DylanMills/ControllerDesign/images/20241011_081829.jpg

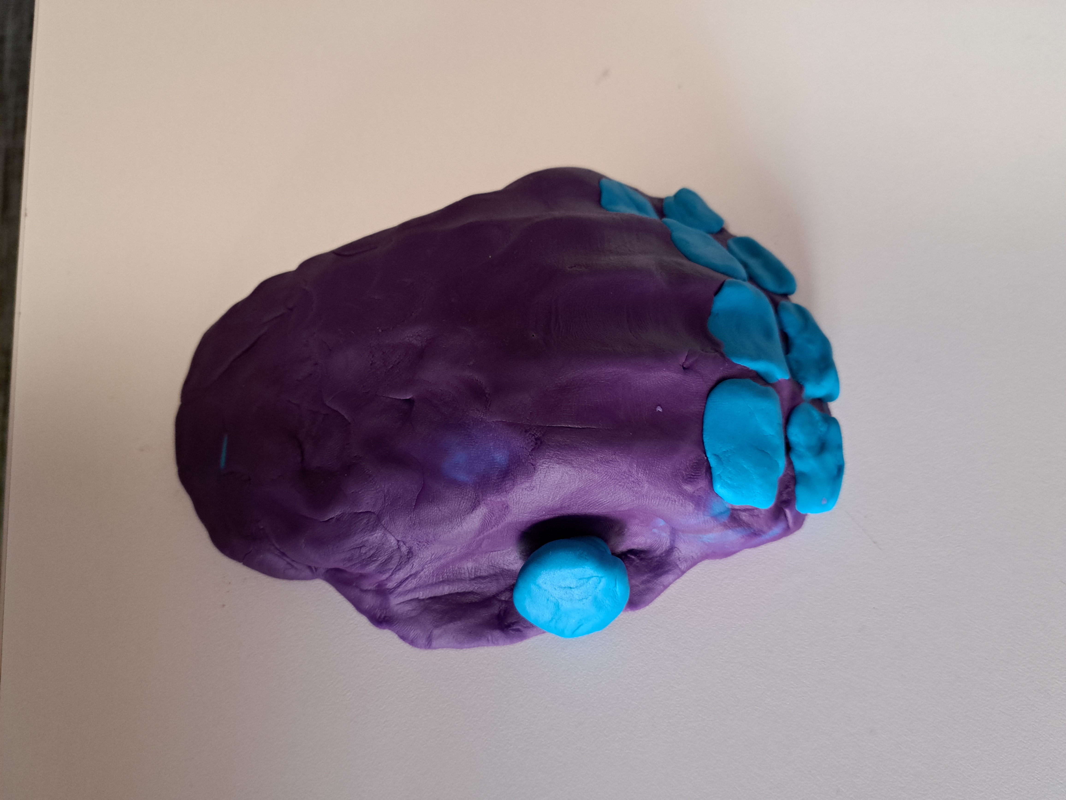
images/20241011_081829.jpg
