DylanMills/ControllerDesign/images/newcontroller.png

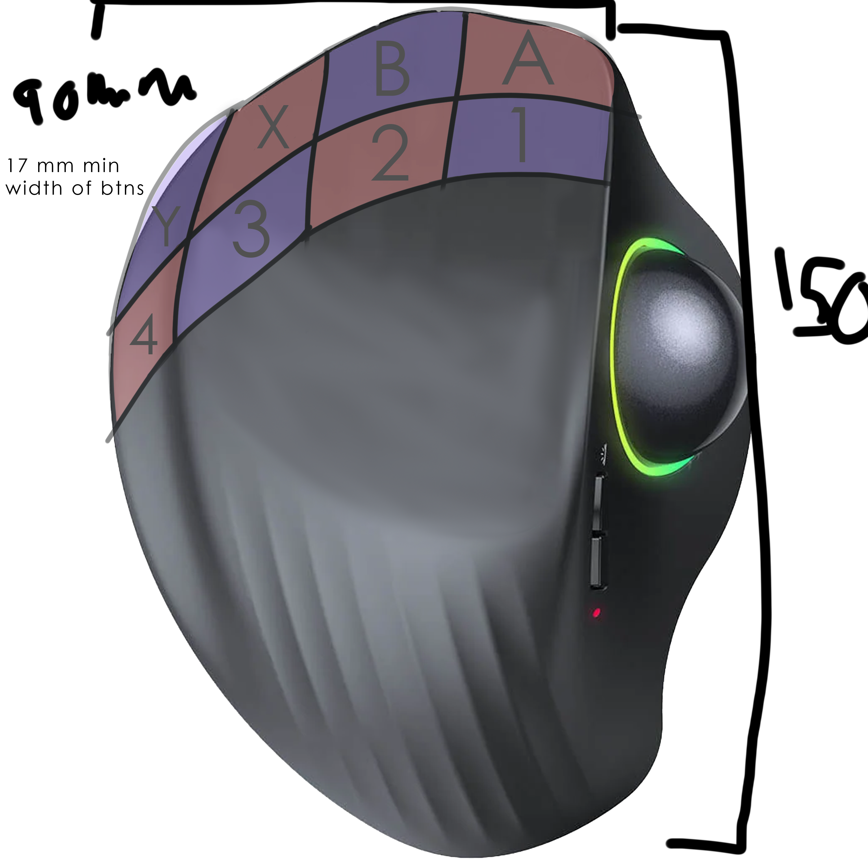
images/newcontroller.png
