DylanMills/ControllerDesign/README.md

# ControllerDesign

### - Dylan Mills
### - Willow Forte

# Overview

This is the design for the new gaming controller, made for PC gamers who want the fluidity of joystick movement and a more ergonomic button layout.

# Links

## Assignment 1
### [Assignent 1 Report PDF](https://github.com/DylanMills/ControllerDesign/blob/main/New%20Input%20Device%20Report.pdf)
### [Wokwi export, with diagram and final Arduino sketch code](https://github.com/DylanMills/ControllerDesign/tree/main/wokwi-diagram-final)
### [Final Demo Video](https://drive.google.com/file/d/1OGJHtCMRwxnxY_OZRE3Fgz9Ho02UFsNs/view?usp=sharing)

## Assignment 2

### [Fusion Project](https://a360.co/3YInzAM)
### [Youtube Presentation](https://youtu.be/R_m9BKb6MnA)
### [Drawings PDF](https://github.com/DylanMills/ControllerDesign/blob/main/ControllerDWG.pdf)
