DylanMills/ControllerDesign/images/20241011_081821.jpg

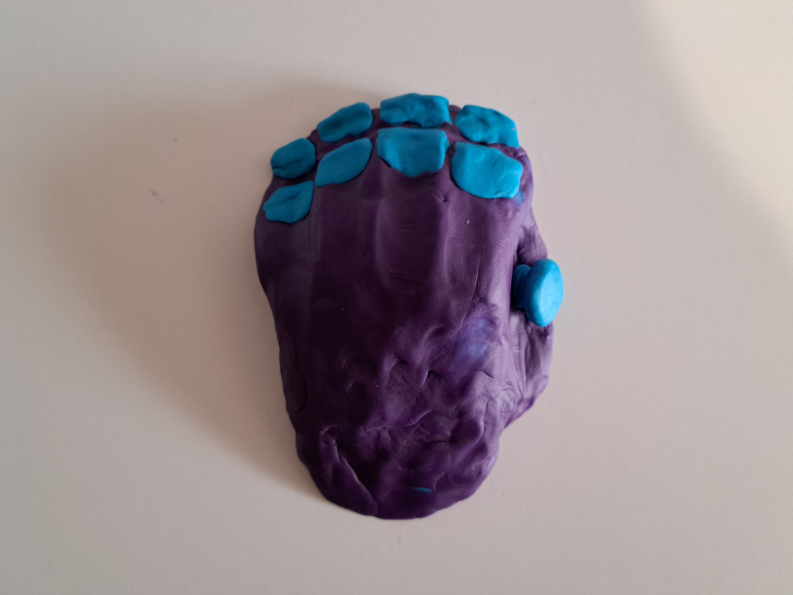
images/20241011_081821.jpg
