DylanMills/ControllerDesign/images/20241011_081920.jpg

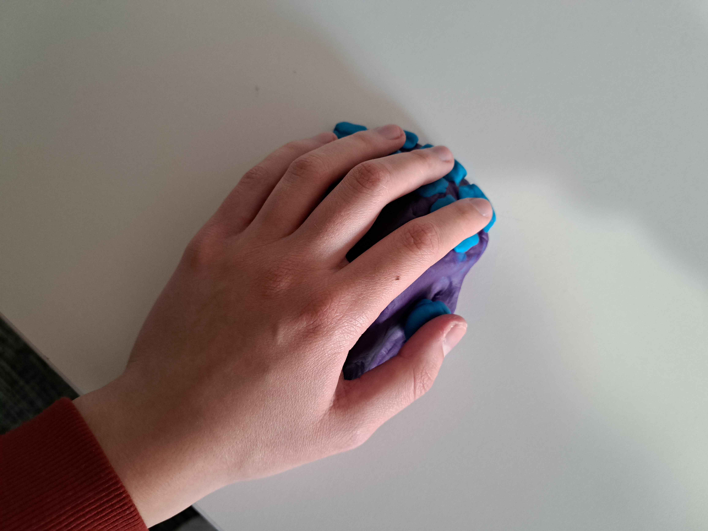
images/20241011_081920.jpg
