DylanMills/ControllerDesign/images/proto_sketches.png

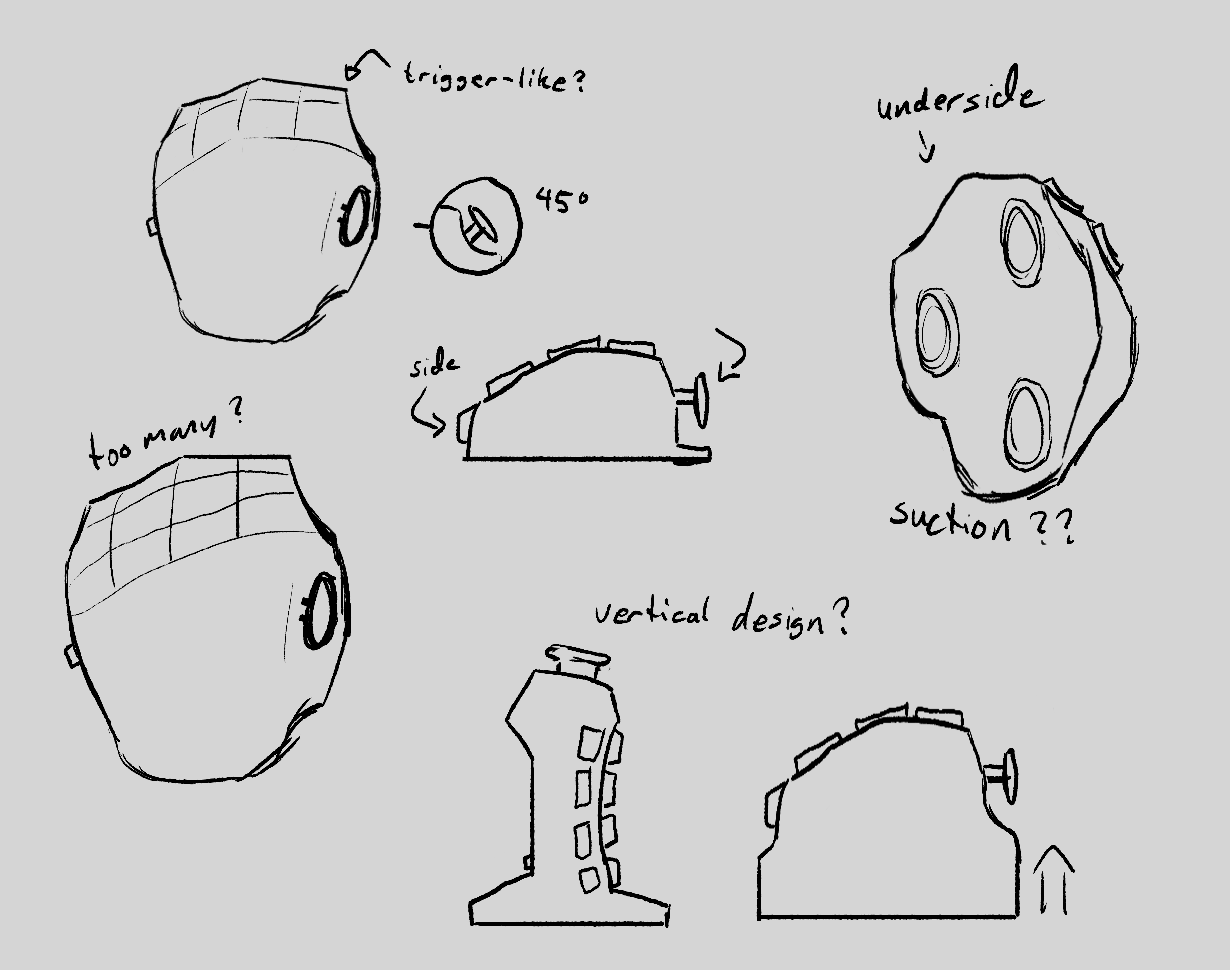
images/proto_sketches.png
