DylanMills/ControllerDesign/images/SystemArchitecture.png

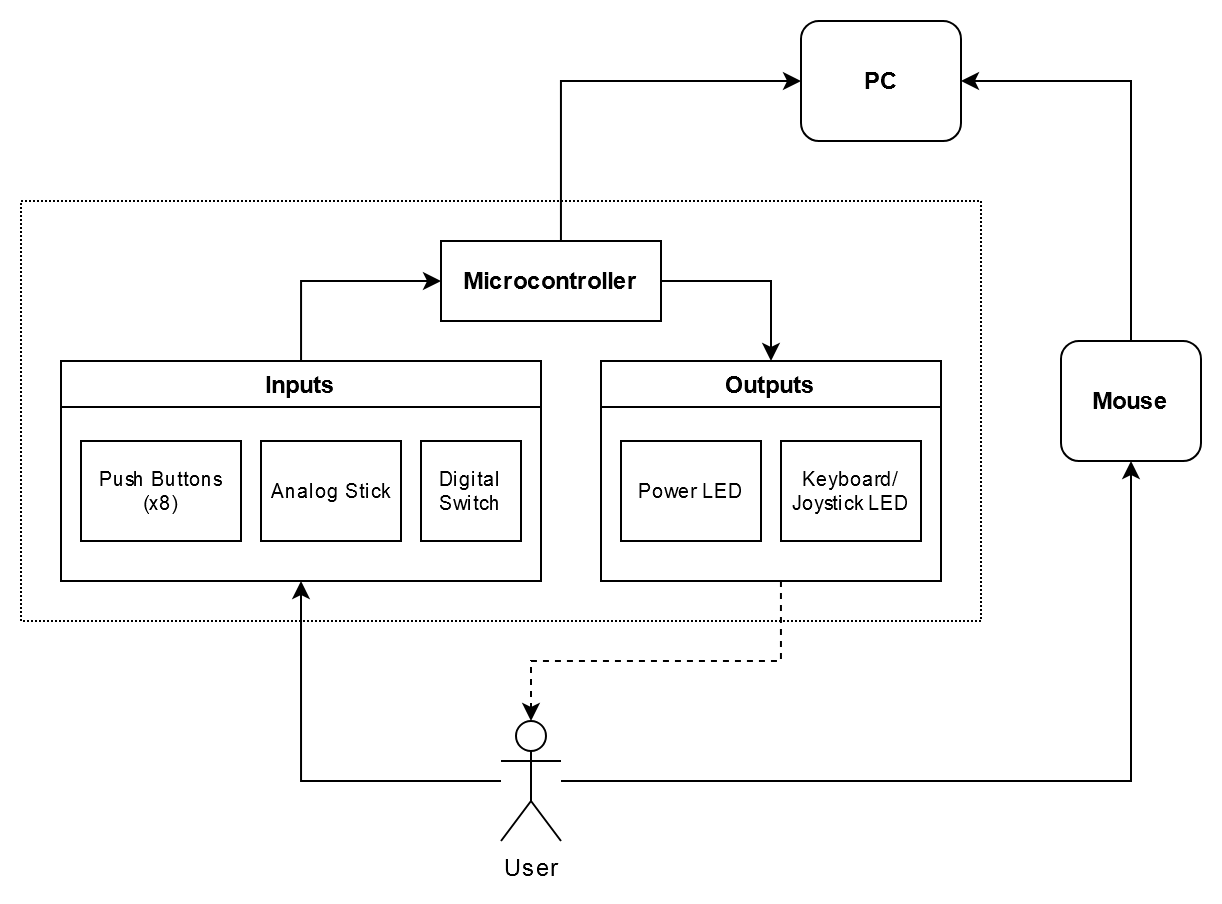
images/SystemArchitecture.png
