DylanMills/ControllerDesign/ControllerDWG.pdf

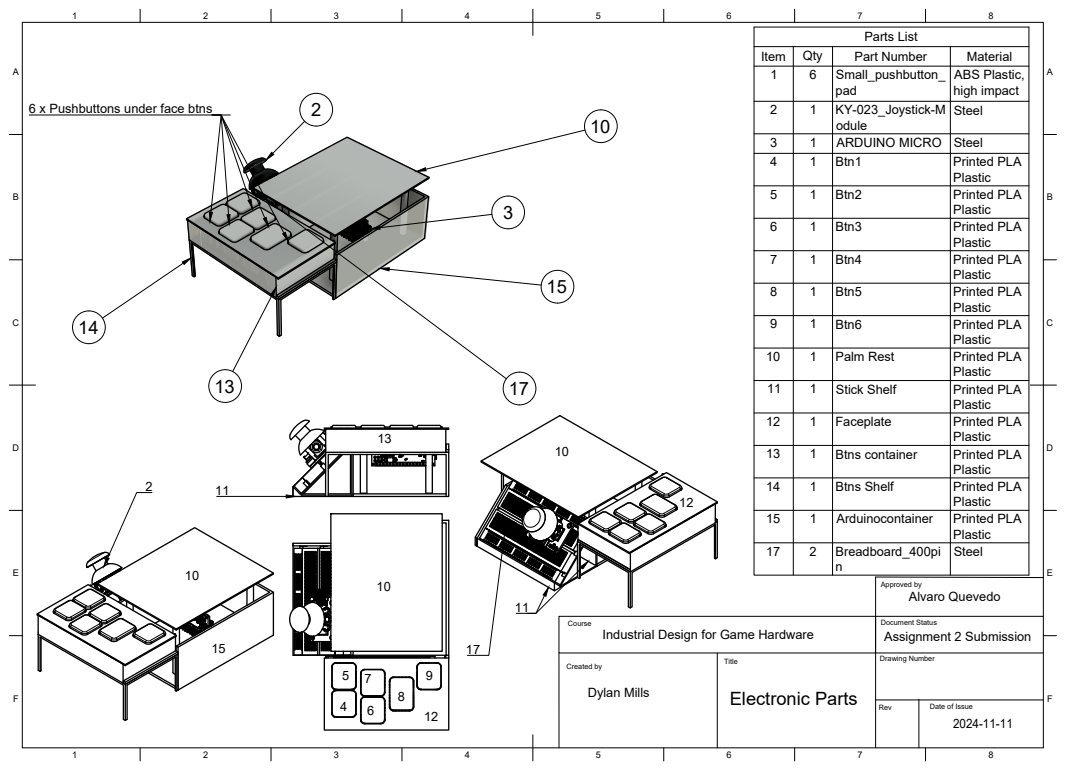
[picture p20: page 1]
Dylan Mills; Alvaro Quevedo; Assignment 2 Submission; Drawing Number; Approved by; Created by; Course; Document Status; Electronic Parts; Parts List; Item; Qty; Part Number; Material; ABS Plastic, high impact; ARDUINO MICRO Steel; Btn1; Printed PLA; Btn2; Btn3; Btn4; Btn5; Btn6; Palm Rest; Stick Shelf; Faceplate; Btns container; Btns Shelf; Arduinocontainer

6 x Pushbuttons under face btns

Industrial Design for Game Hardware

Date of Issue

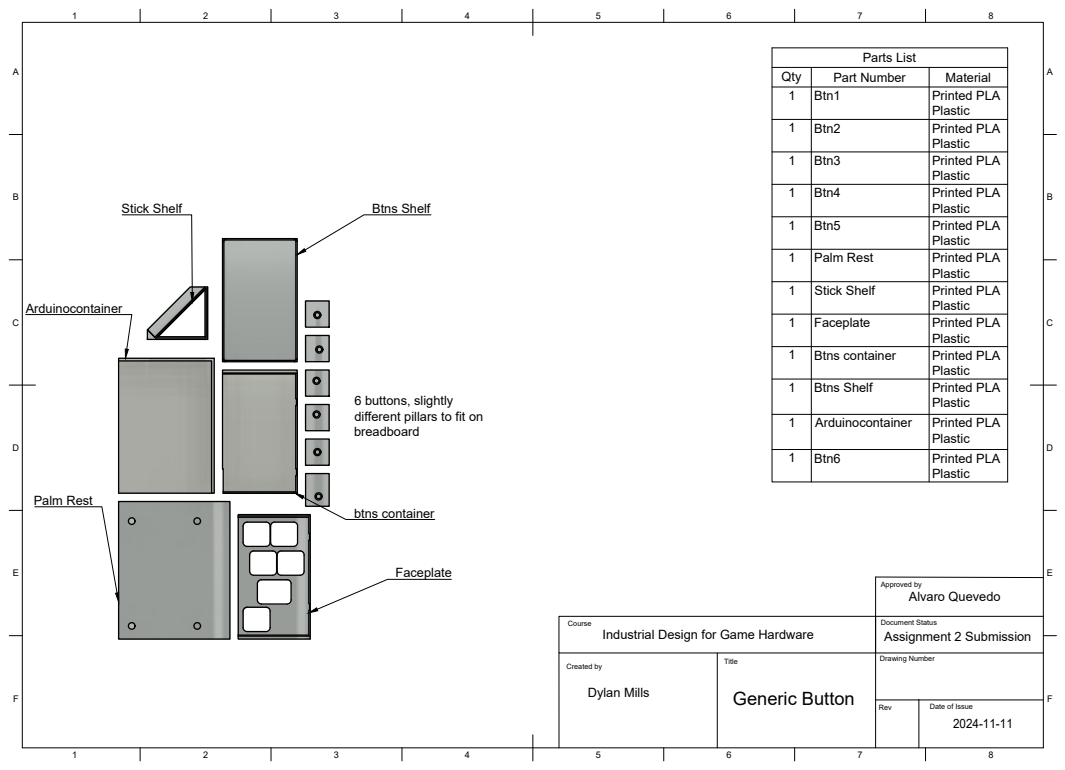
[picture p21: page 2]
Dylan Mills; Alvaro Quevedo; Assignment 2 Submission; Drawing Number; Approved by; Created by; Course; Document Status; Generic Button; Parts List; Stick Shelf; Btns Shelf; Palm Rest; btns container

Qty | Part Number | Material
1 | Btn1 | Printed PLA Plastic

1 | Btn2 | Printed PLA Plastic

1 | Btn3 | Printed PLA Plastic

1 | Btn4 | Printed PLA Plastic

1 | Btn5 | Printed PLA Plastic

1 | Palm Rest | Printed PLA Plastic

1 | Stick Shelf | Printed PLA Plastic

1 | Faceplate | Printed PLA Plastic

1 | Btns container | Printed PLA Plastic

1 | Btns Shelf | Printed PLA Plastic

6 buttons, slightly
different pillars to fit on
breadboard

1 | Arduinocontainer | Printed PLA Plastic

1 | Btn6 | Printed PLA Plastic

Industrial Design for Game Hardware

Date of Issue

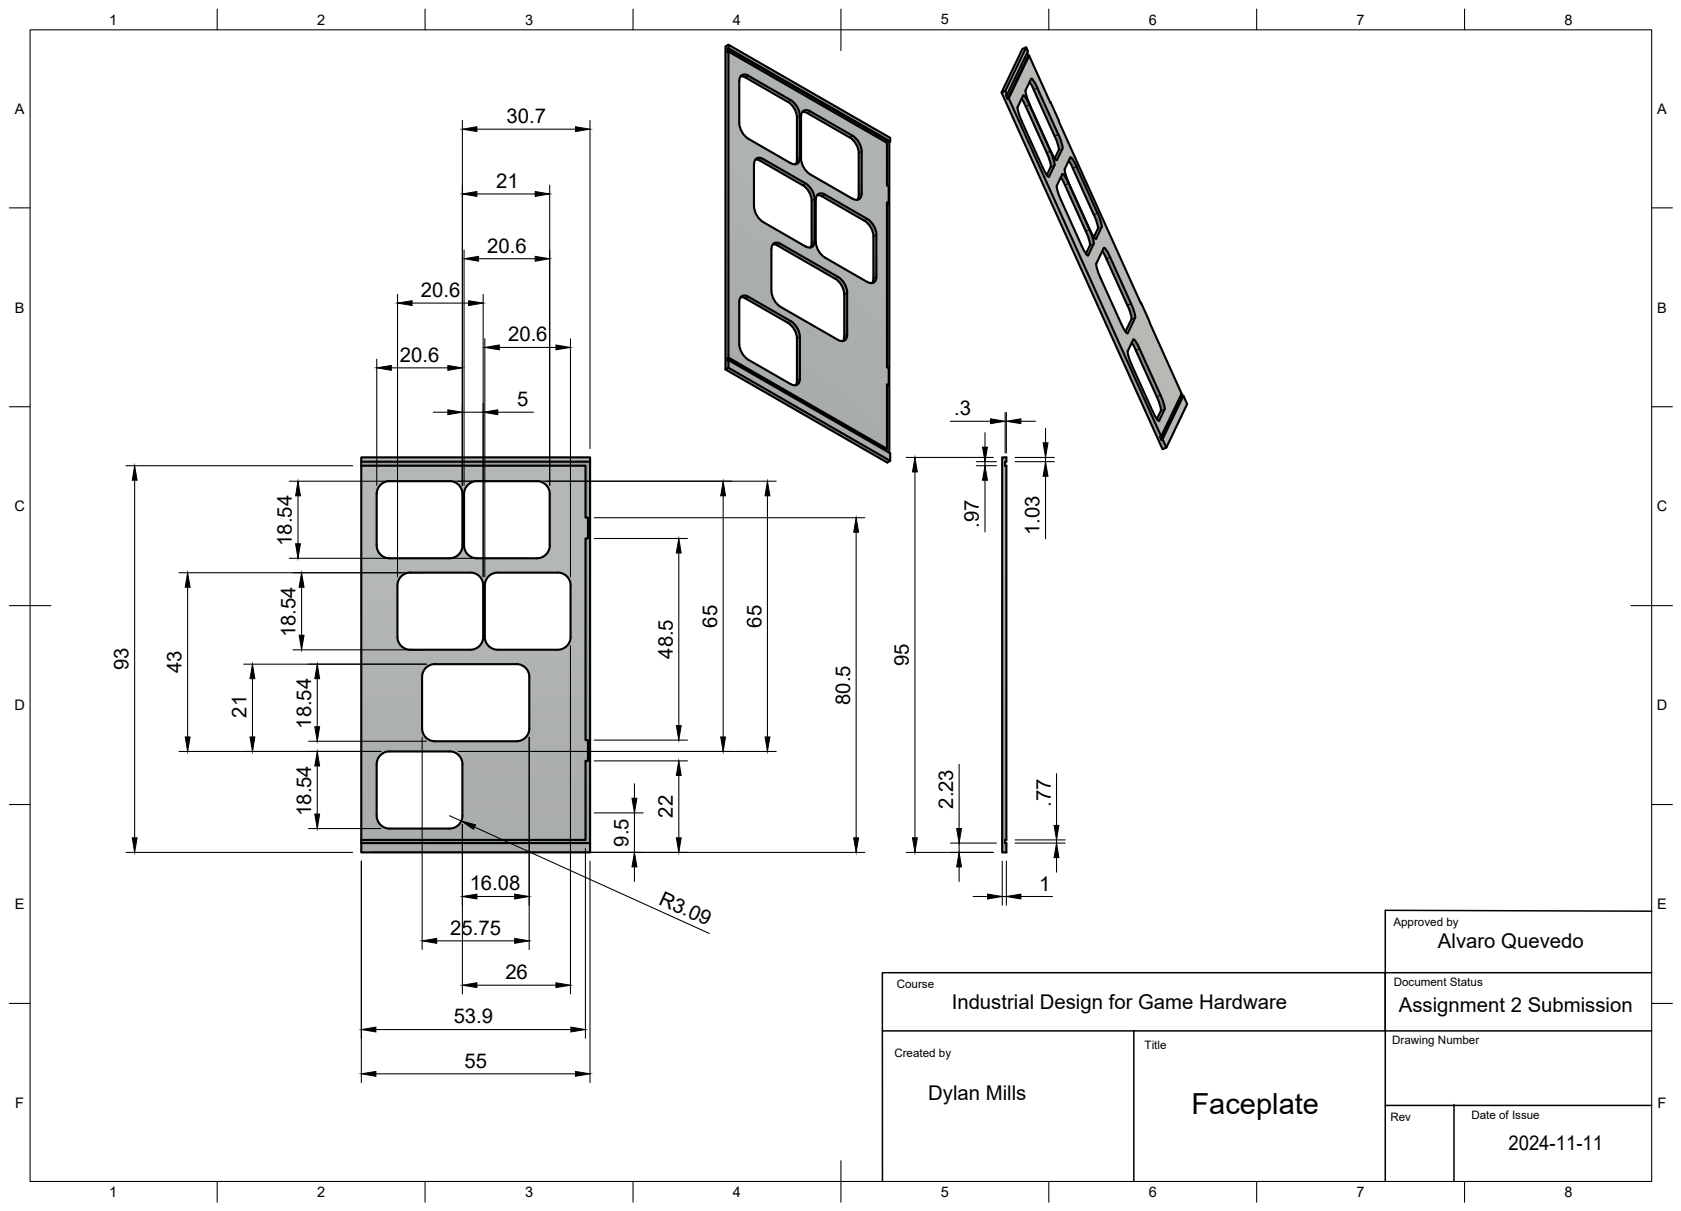
[picture p22: page 3]
Dylan Mills; Alvaro Quevedo; Assignment 2 Submission; Drawing Number; Approved by; Created by; Course; Document Status

Industrial Design for Game Hardware

Date of Issue

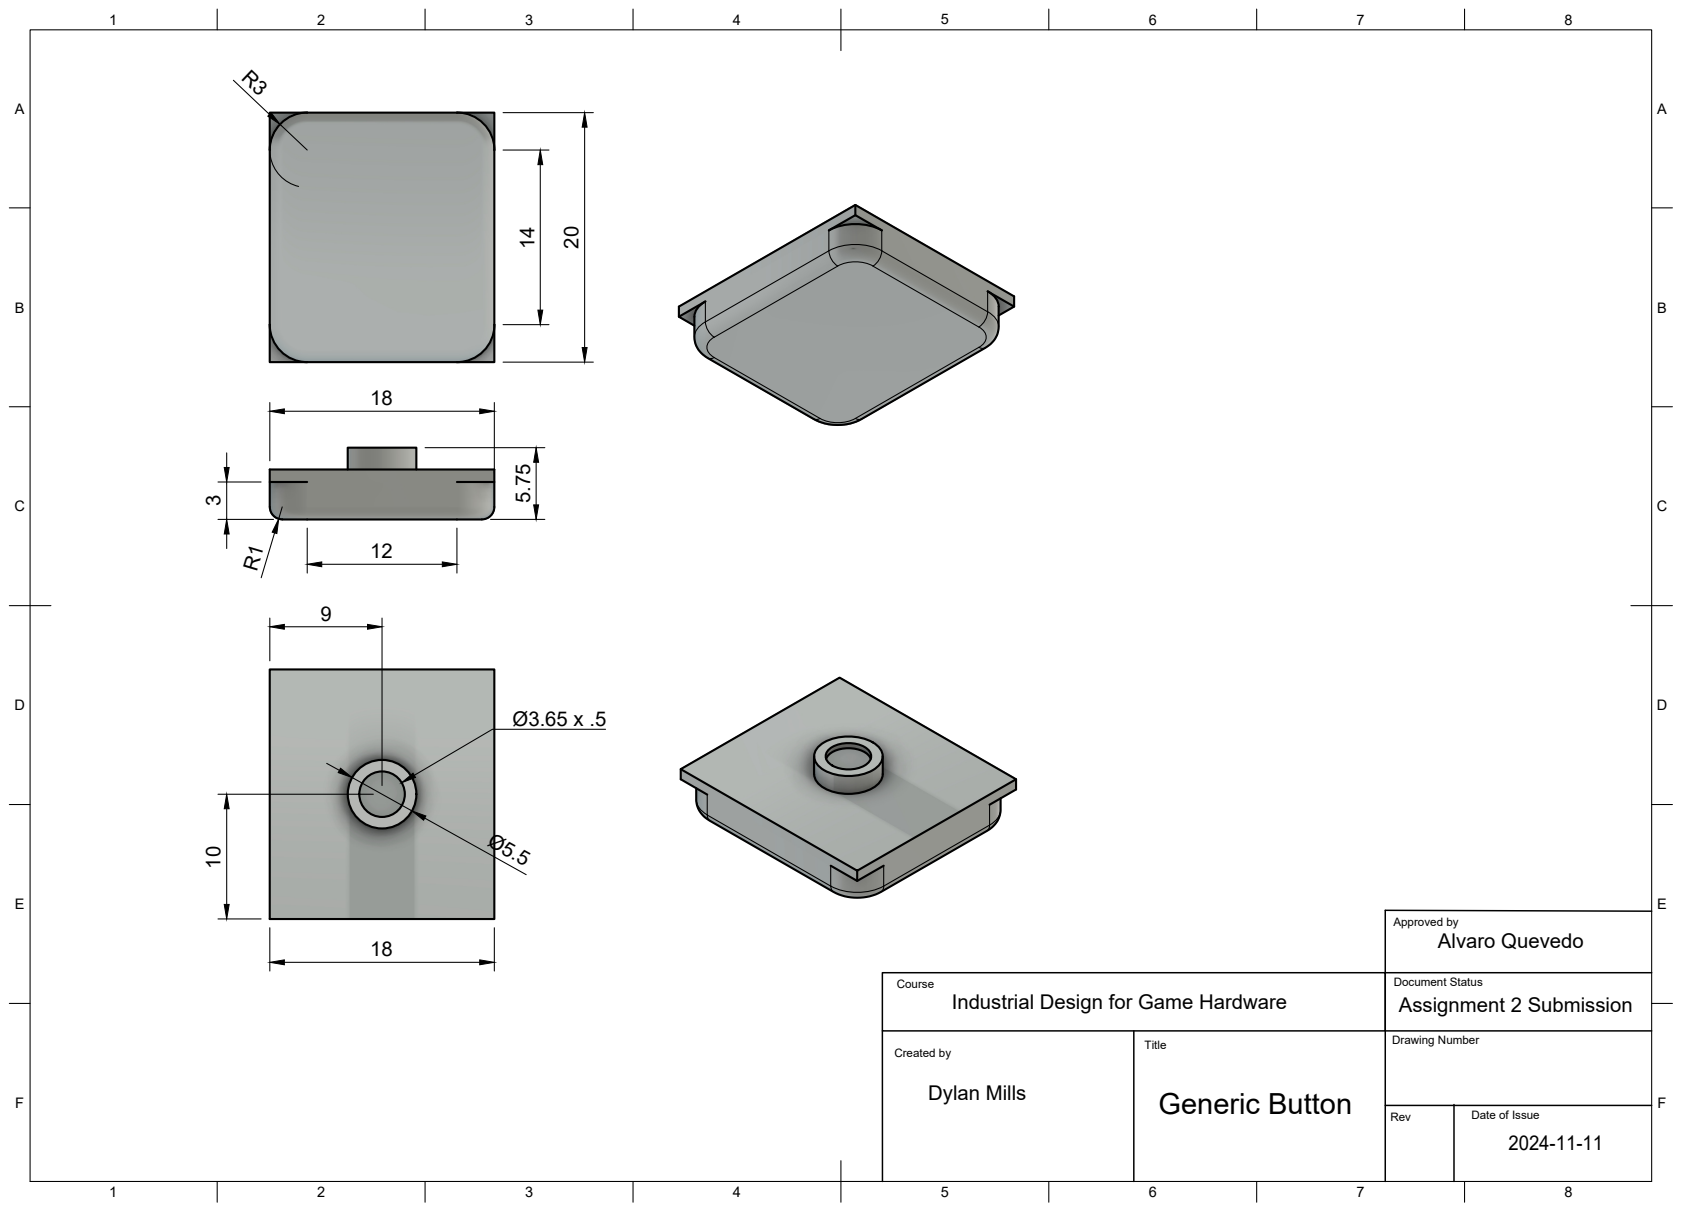
[picture p23: page 4]
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

Industrial Design for Game Hardware

Date of Issue

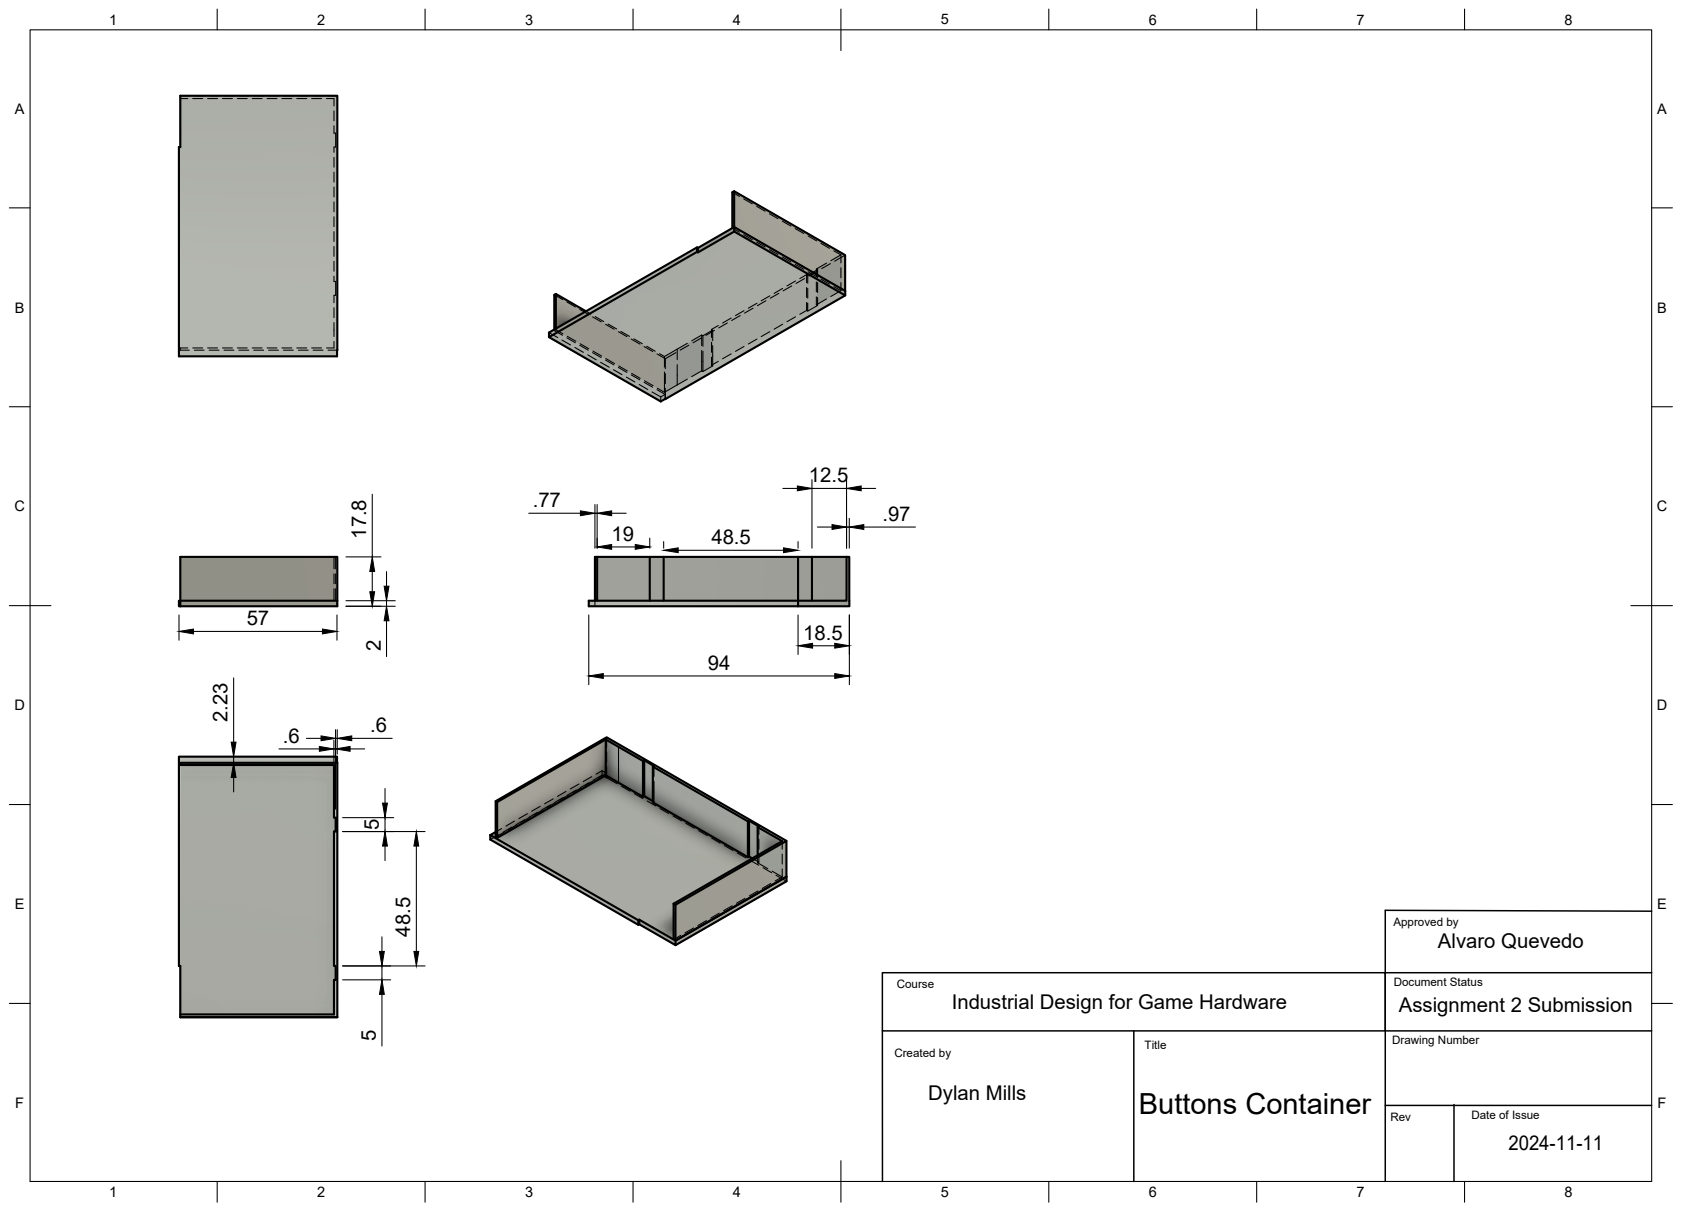
[picture p24: page 5]
Dylan Mills; Alvaro Quevedo; Assignment 2 Submission; Drawing Number; Approved by; Created by; Course; Document Status; Buttons Container

Industrial Design for Game Hardware

Date of Issue

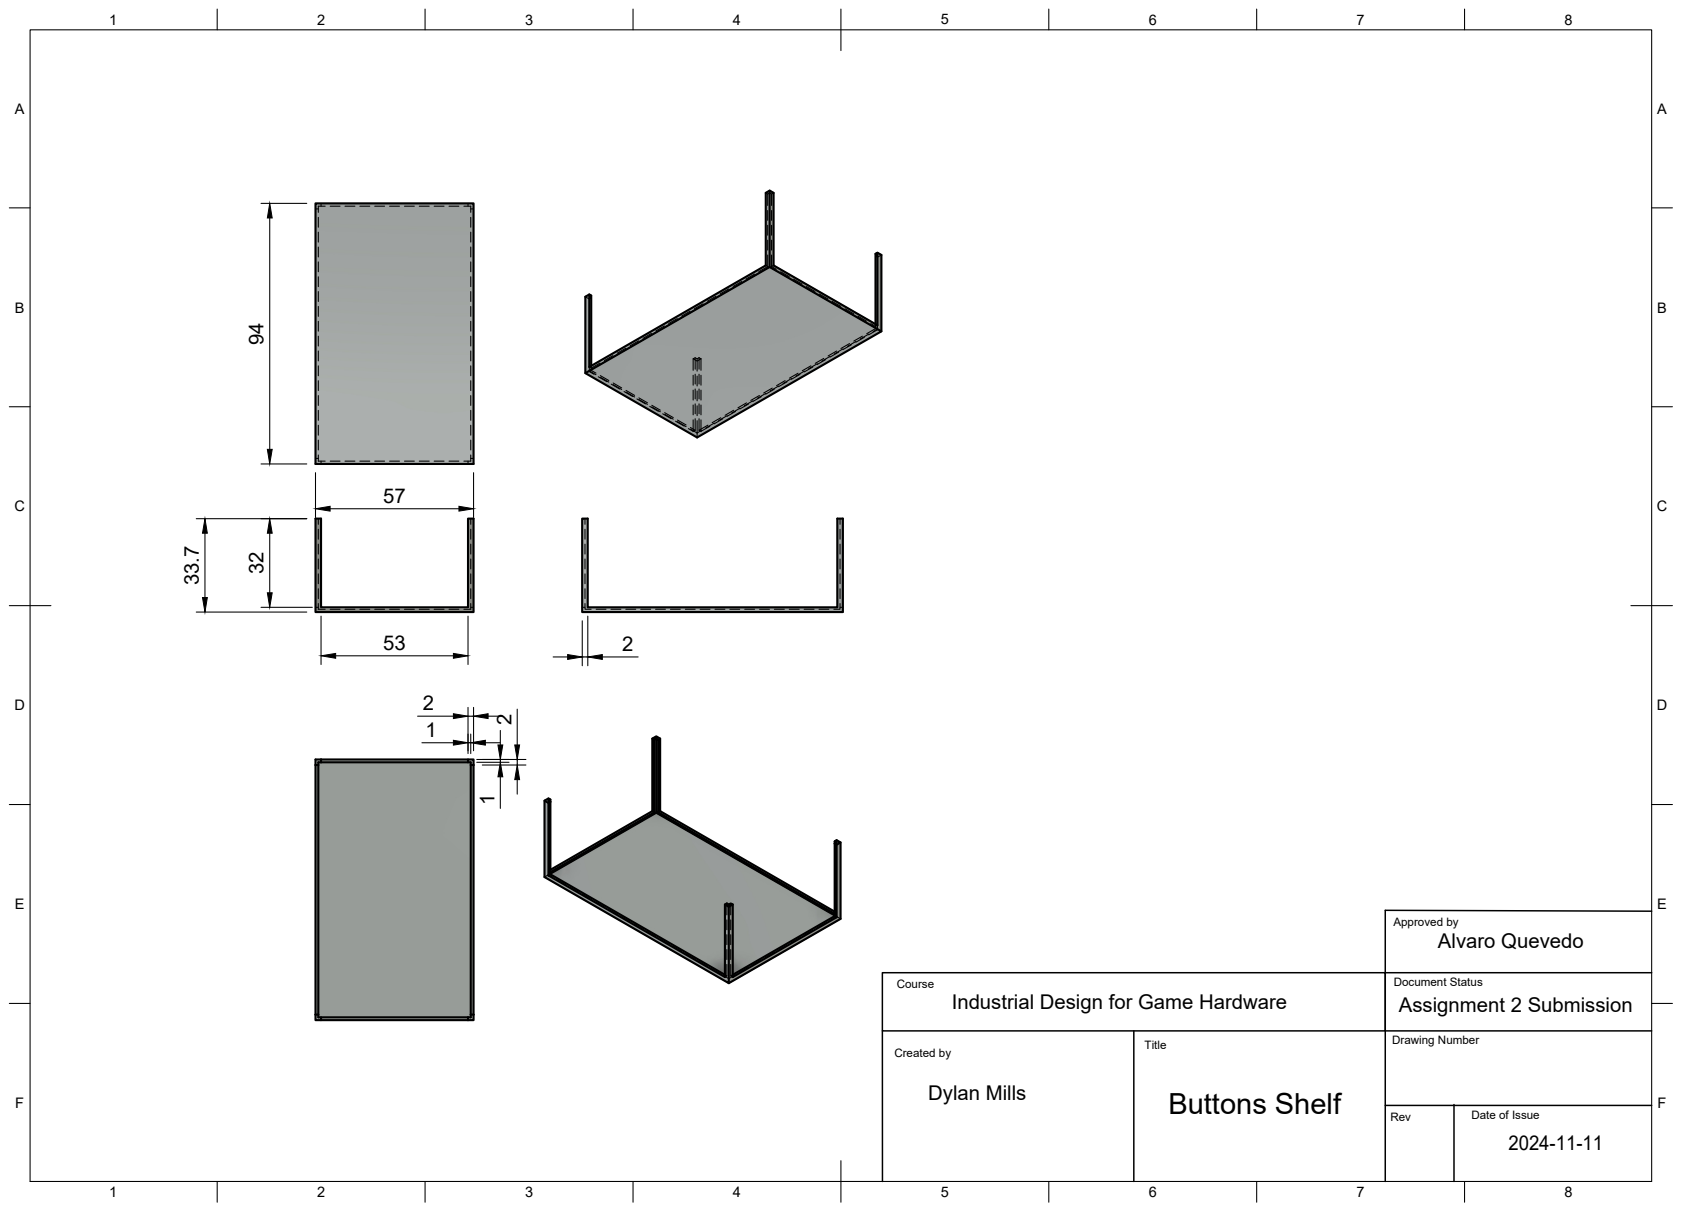
[picture p25: page 6]
Dylan Mills; Alvaro Quevedo; Assignment 2 Submission; Drawing Number; Approved by; Created by; Course; Document Status; Buttons Shelf

Industrial Design for Game Hardware

Date of Issue

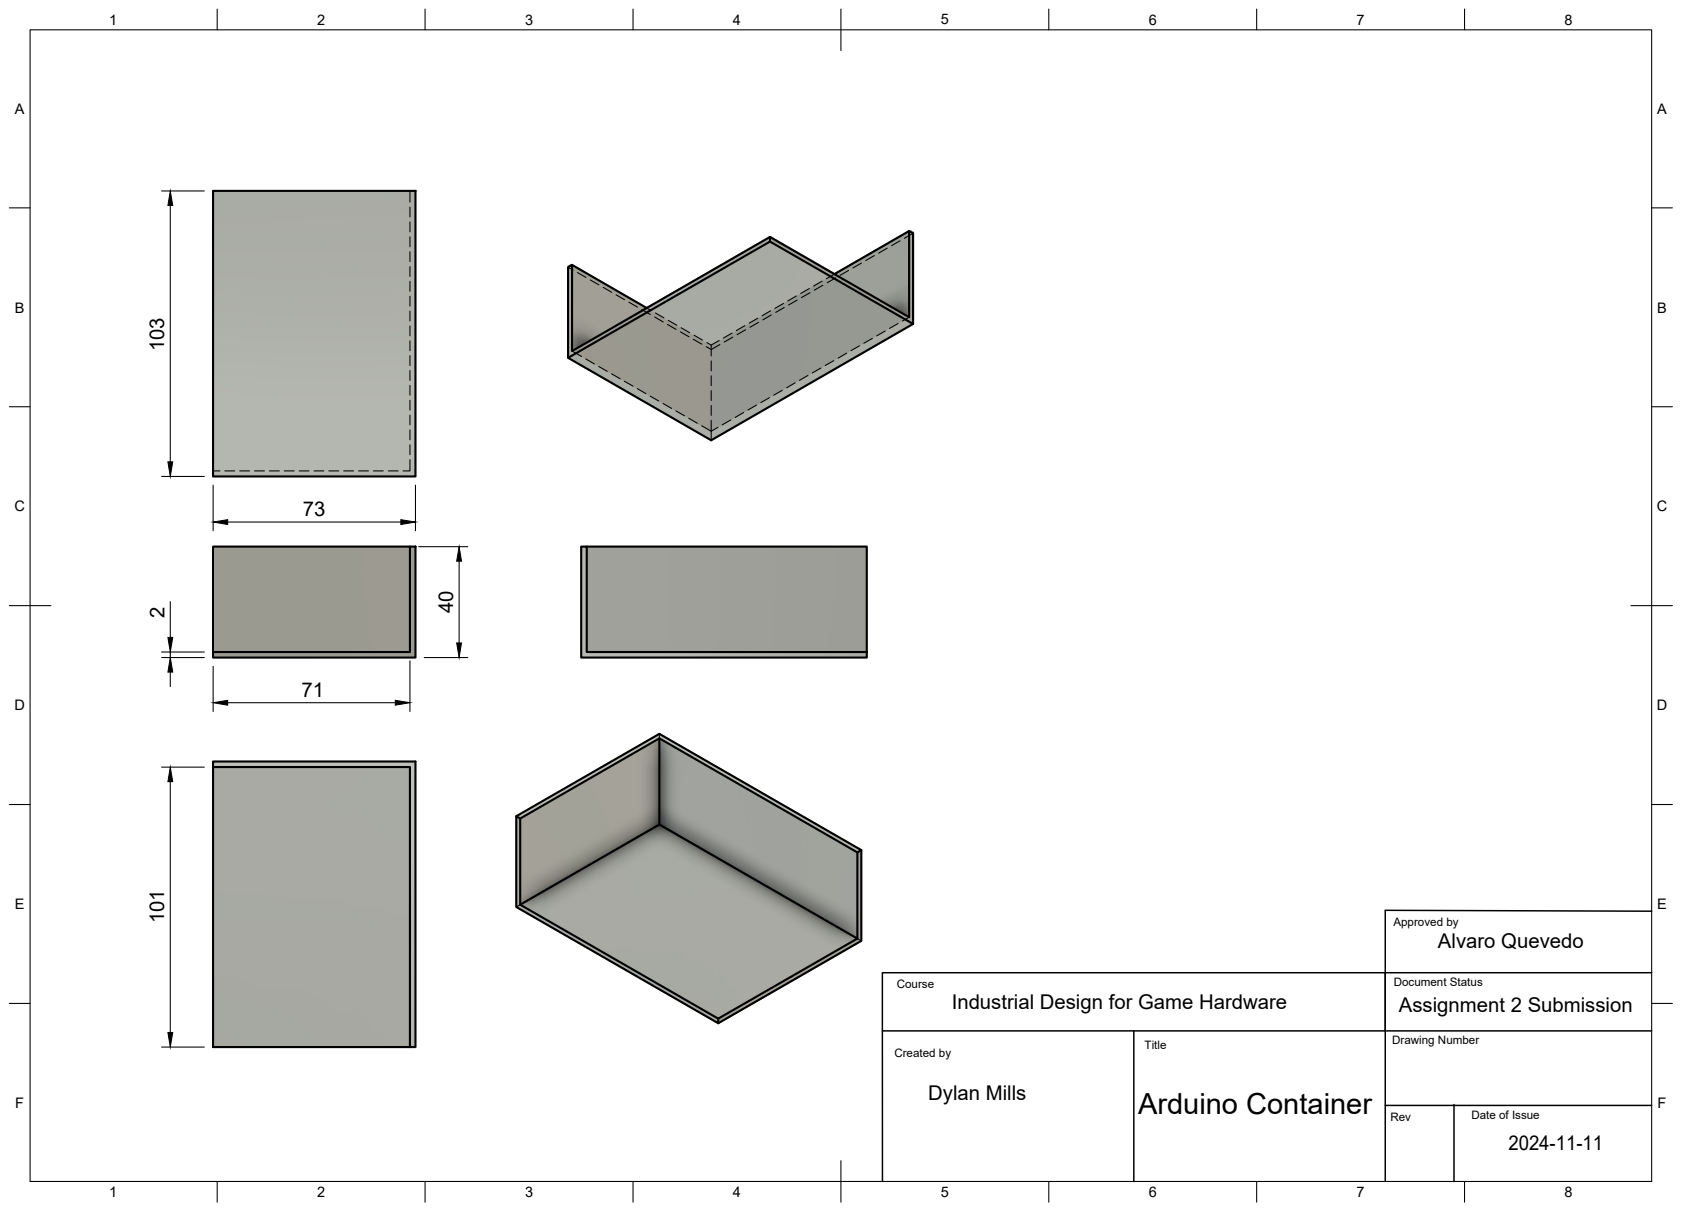
[picture p26: page 7]
Dylan Mills; Alvaro Quevedo; Assignment 2 Submission; Drawing Number; Approved by; Created by; Course; Document Status; Arduino Container

Industrial Design for Game Hardware

Date of Issue

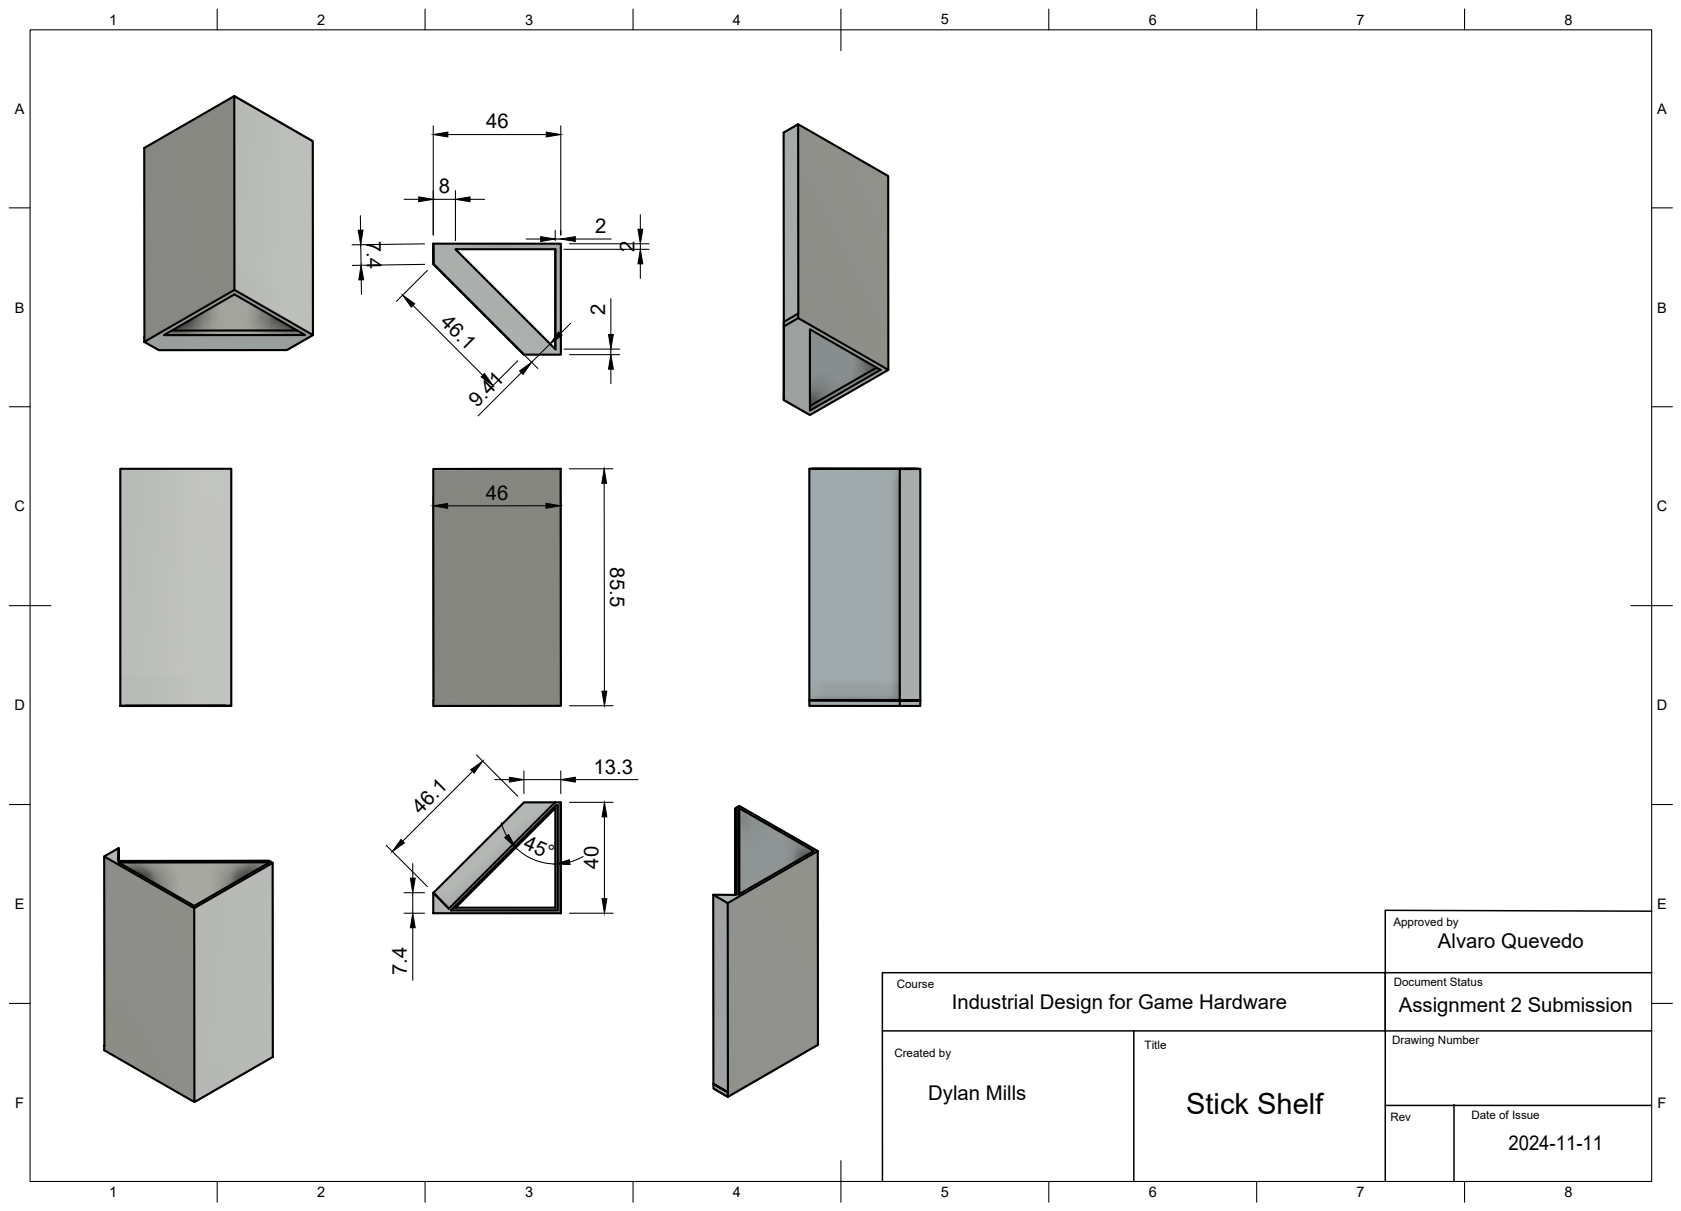
[picture p27: page 8]
Dylan Mills; Alvaro Quevedo; Assignment 2 Submission; Drawing Number; Approved by; Created by; Course; Document Status; Stick Shelf

Industrial Design for Game Hardware

Date of Issue

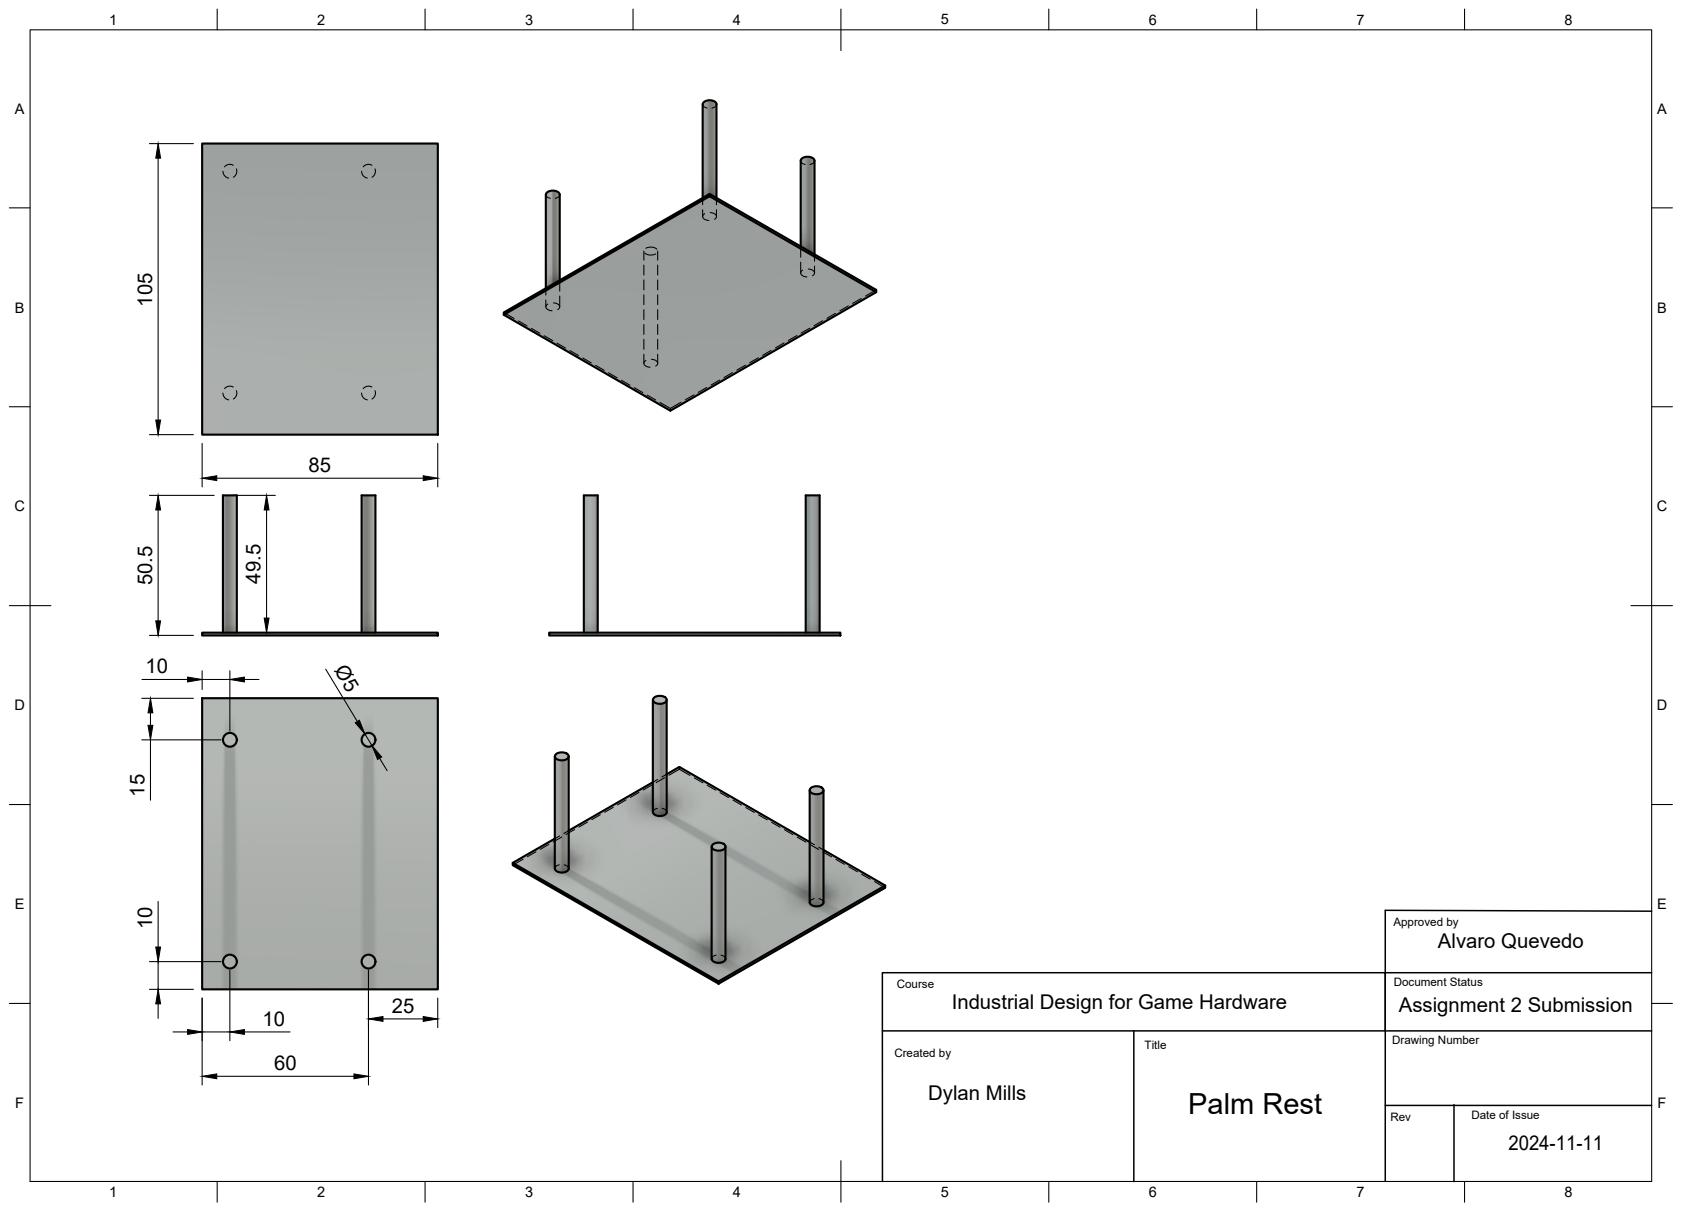
[picture p28: page 9]
Dylan Mills; Alvaro Quevedo; Assignment 2 Submission; Drawing Number; Approved by; Created by; Course; Document Status; Palm Rest

Industrial Design for Game Hardware

Date of Issue
